fablaboulu/fabbed_vr_glasses/README.md

# Fabbed VR glasses
VR glasses fabricated at Fab Lab using SRM-20 (CNC precision milling machine) and laser cutter. Lenses are made out of acrylic.

Author: Gleb Bulygin
