fablaboulu/fabbed_vr_glasses/vr_set.pdf

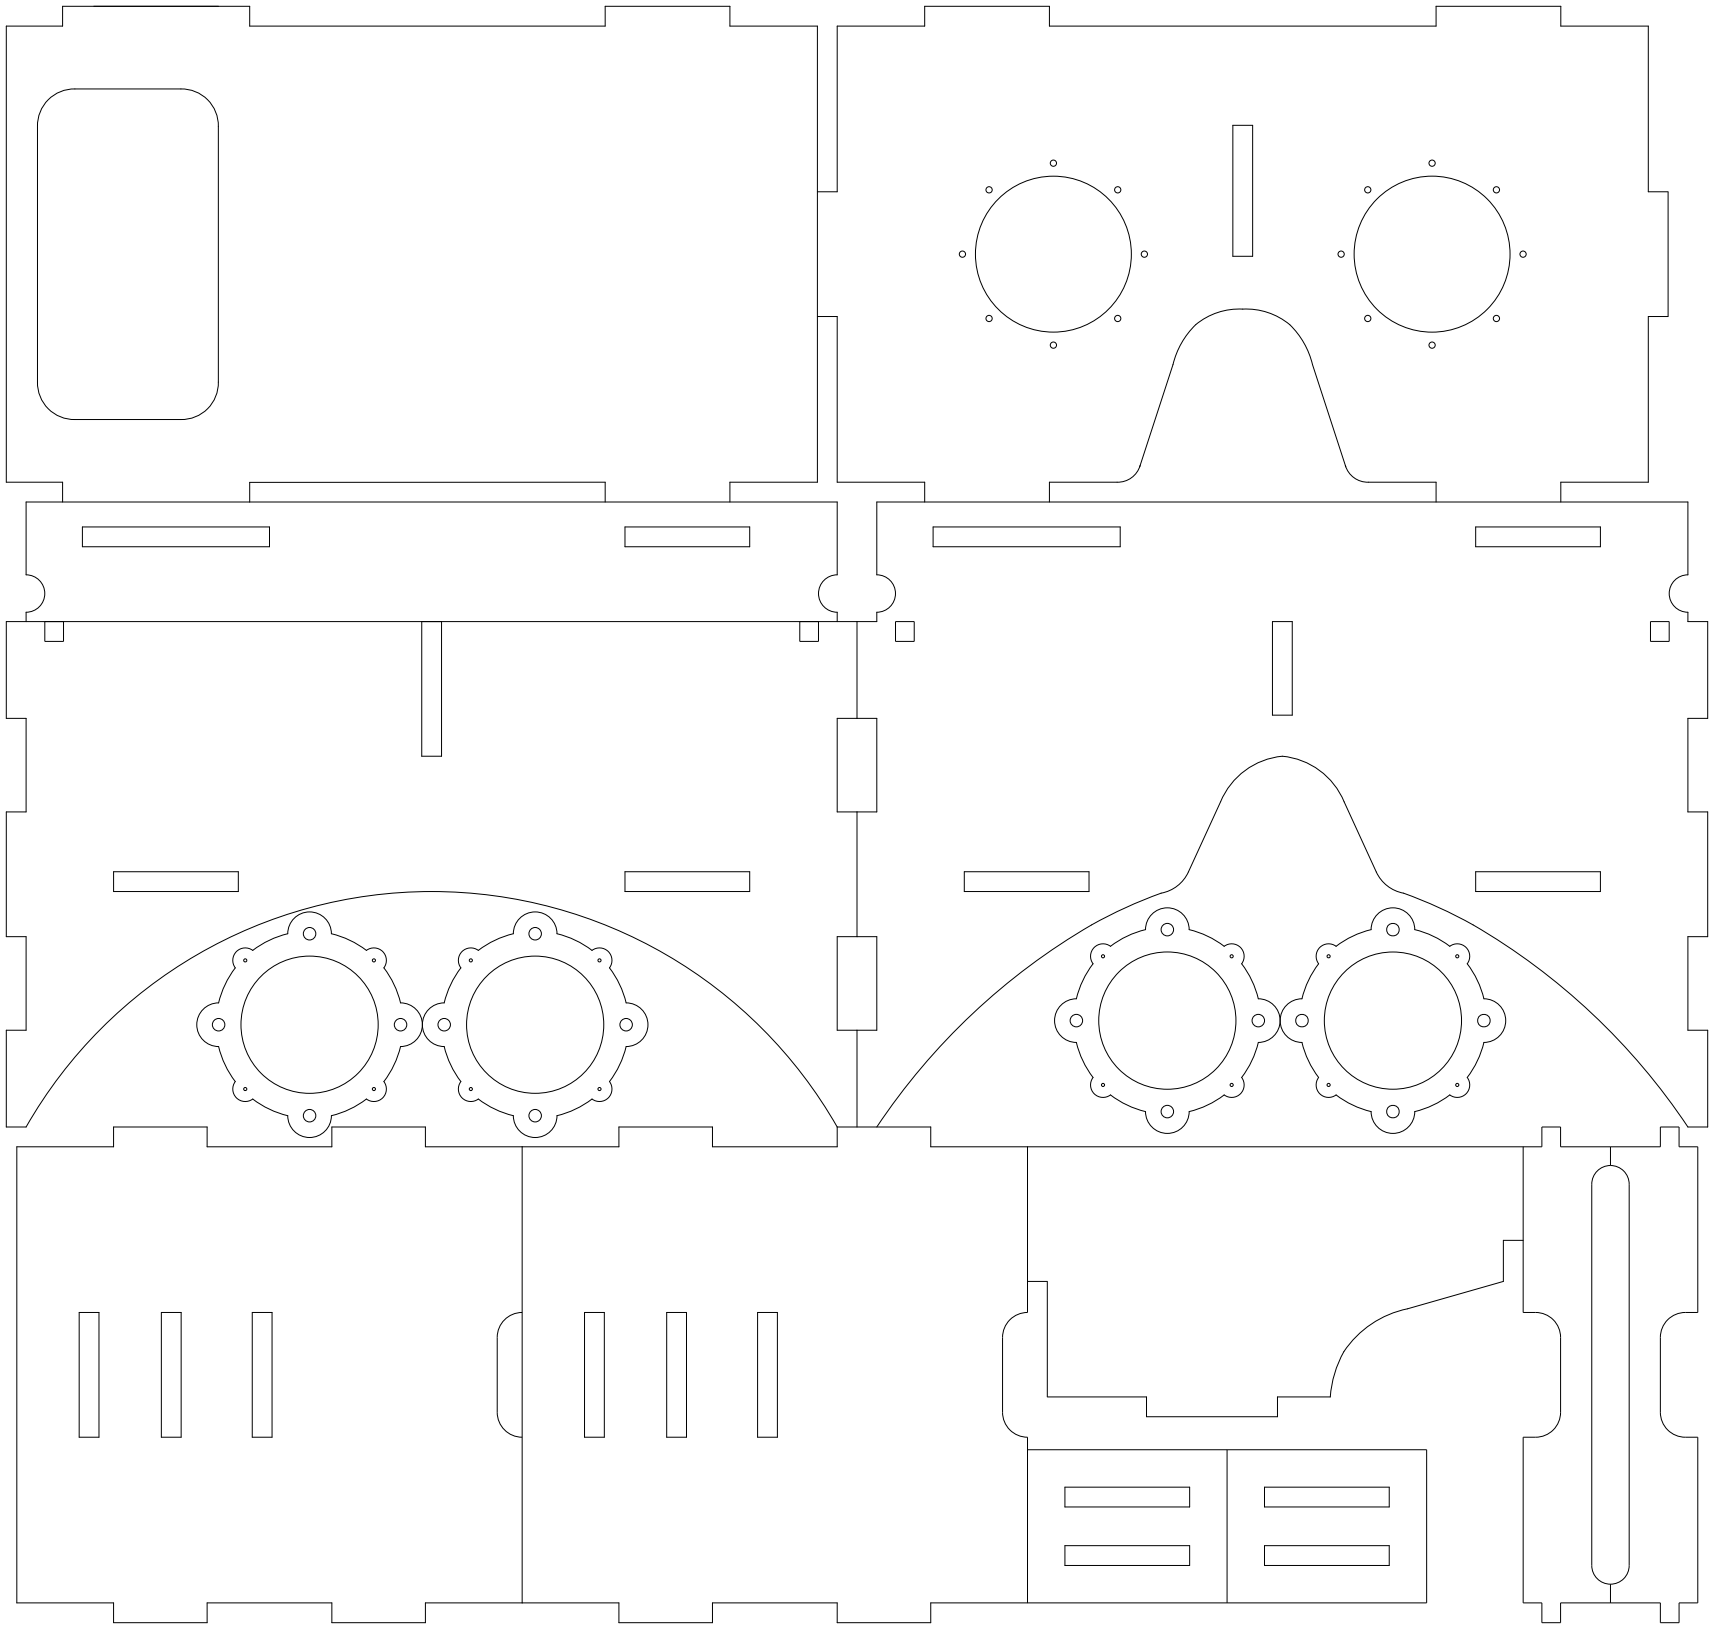
[picture p11: page 1]
