fablaboulu/fabbed_vr_glasses/lens_milling.stl

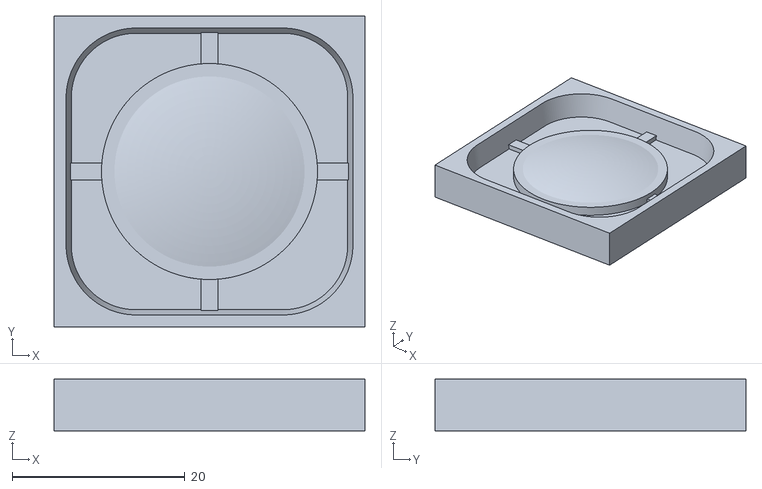
[picture p9: CAD file, 2020-04-15]
lens_milling.stl
36.0 x 36.0 x 6.00
