fablaboulu/fabbed_vr_glasses/lens.stl

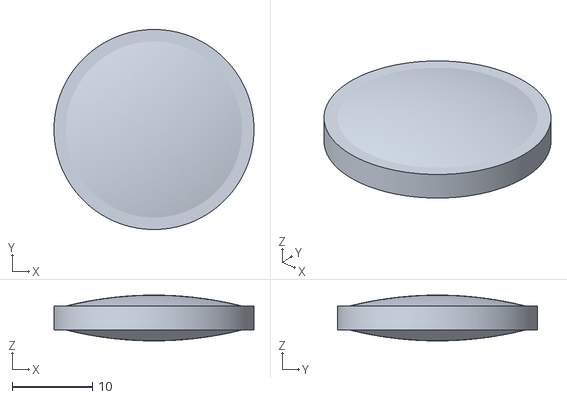
[picture p10: CAD file, 2020-04-15]
lens.stl
25.0 x 25.0 x 5.73
